VR4Health/Krzeslo/(list of files, cad)

Other CAD files:
Docsy/Drawing1.dwg
Aktutator.iam
Cylinder.ipt
FEM/FemPodstawa.iam
FEM/OldVersions/FemPodstawa.0002.iam
KinematicMidWay.ipt
OldVersions/Aktutator.0040.iam
OldVersions/Cylinder.0007.ipt
OldVersions/KinematicMidWay.0001.ipt
OldVersions/Part1.0008.ipt
OldVersions/PodstawaFem.0001.ipt
OldVersions/platforma.0006.ipt
OldVersions/platforma.0070.iam
OldVersions/tlok.0017.ipt
Part1.ipt
PodstawaFem.ipt
PodstawaFem_MIR.ipt
WynikiZadaniaOdwrotnego/OldVersions/PN EN 10060 - 75 - 50.0004.ipt
WynikiZadaniaOdwrotnego/OldVersions/PN EN 10219-2 - 100 x 80 x 6 - 655.0002.ipt
WynikiZadaniaOdwrotnego/OldVersions/PN EN 10219-2 - 160 x 80 x 8 - 545.0002.ipt
WynikiZadaniaOdwrotnego/PN EN 10059 - 20-0,001.ipt
WynikiZadaniaOdwrotnego/PN EN 10060 - 75 - 50.ipt
WynikiZadaniaOdwrotnego/PN EN 10060 - 75 - 50_MIR.ipt
WynikiZadaniaOdwrotnego/PN EN 10060 - 75 - 50_MIR1.ipt
WynikiZadaniaOdwrotnego/PN EN 10060 - 75 - 50_MIR2.ipt
WynikiZadaniaOdwrotnego/PN EN 10060 - 75 - 50_MIR_MIR.ipt
WynikiZadaniaOdwrotnego/PN EN 10060 - 75 - 50_MIR_MIR1.ipt
WynikiZadaniaOdwrotnego/PN EN 10219-2 - 100 x 80 x 6 - 655.ipt
WynikiZadaniaOdwrotnego/PN EN 10219-2 - 100 x 80 x 6 - 655_MIR.ipt
WynikiZadaniaOdwrotnego/PN EN 10219-2 - 100 x 80 x 6 - 655_MIR1.ipt
WynikiZadaniaOdwrotnego/PN EN 10219-2 - 100 x 80 x 6 - 655_MIR2.ipt
WynikiZadaniaOdwrotnego/PN EN 10219-2 - 100 x 80 x 6 - 655_MIR_MIR.ipt
WynikiZadaniaOdwrotnego/PN EN 10219-2 - 100 x 80 x 6 - 655_MIR_MIR1.ipt
WynikiZadaniaOdwrotnego/PN EN 10219-2 - 160 x 80 x 6 - 0,001.ipt
WynikiZadaniaOdwrotnego/PN EN 10219-2 - 160 x 80 x 8 - 545.ipt
WynikiZadaniaOdwrotnego/PN EN 10219-2 - 160 x 80 x 8 - 545_MIR.ipt
WynikiZadaniaOdwrotnego/PN EN 10219-2 - 160 x 80 x 8 - 545_MIR1.ipt
WynikiZadaniaOdwrotnego/PN EN 10219-2 - 160 x 80 x 8 - 545_MIR2.ipt
WynikiZadaniaOdwrotnego/PN EN 10219-2 - 160 x 80 x 8 - 545_MIR_MIR.ipt
WynikiZadaniaOdwrotnego/PN EN 10219-2 - 160 x 80 x 8 - 545_MIR_MIR1.ipt
WynikiZadaniaOdwrotnego/PN EN 10219-2 - 180 x 100 x 6 - 547.ipt
WynikiZadaniaOdwrotnego/PN-91_H-93419 - IPE140 - 1500.ipt
fotel.ipt
platforma.iam
platforma.ipt
podstawa/Ceownik_PN-86_H-93403 - C 100x50 - 0,001.ipt
podstawa/Ceownik_PN-86_H-93403 - C 100x50 -1200.ipt
sitting_dummy_1_76_m_22111111611.ipt
tlok.ipt
