VR4Health/Krzeslo/(commit log)

2016-09-05 wersja z sierpnia
    [Aktutator.0034.iam, Aktutator.iam, Cylinder.ipt, KinematicMidWay.ipt, Part1.ipt, platforma.0032.iam, platforma.iam, platforma.ipt]
2016-10-20 na nowym dysku
    [Aktutator.0034.iam, Aktutator.0035.iam, Aktutator.iam, Cylinder.0004.ipt, Cylinder.ipt, KinematicMidWay.0001.ipt, KinematicMidWay.ipt, Part1.0002.ipt]
2016-10-30 z czlowieczkiem, po obliczeniach geom.
    [Ceownik_PN-86_H-93403 - C 100x50 - 0,001.ipt, Ceownik_PN-86_H-93403 - C 100x50 -1200.ipt, Part1.0002.ipt, Part1.0004.ipt, Part1.ipt, platforma.0004.ipt, platforma.0006.ipt, platforma.0035.iam]
2016-11-29 14 stron
    [Aktutator.0035.iam, Aktutator.0038.iam, Aktutator.iam, Cylinder.0004.ipt, Cylinder.0005.ipt, Cylinder.ipt, Drawing1.dwg, Part1.0004.ipt]
2016-12-02 po korekcie
    [Aktutator.0038.iam, Aktutator.0040.iam, Aktutator.iam, Cylinder.0005.ipt, Cylinder.0007.ipt, Cylinder.ipt, Drawing1.dwg, Part1.0005.ipt]
2016-12-03 pre para drugiej klasy
    [platforma.0061.iam, platforma.0067.iam, platforma.iam]
2016-12-05 połowa algorytmu opisana
    [parametry.xlsx, platforma.0067.iam, platforma.0069.iam, platforma.iam]
